mjmorano/Magnetometer-System/3D Models/Magnetometer_Full.stp

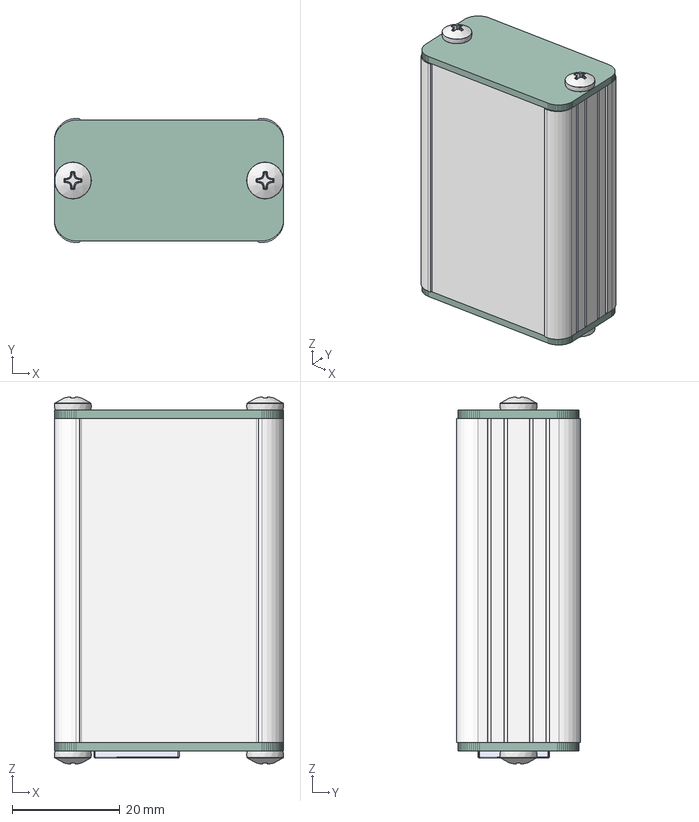
[picture p1: CAD file, 2025-02-03]
3D Models/Magnetometer_Full.stp
42.5 x 23.0 x 68.0 mm
Extrusion Tube w. Inlay 60mm
Rear Panel_1
magnetometer panel PCB
C_1206_3216Metric_1 x 4
R_Array_Convex_4x0603_1 x 2
R_0603_1608Metric_1 x 6
C_0603_1608Metric_1 x 5
SSOP_16_39x49mm_P0635mm
SOIC_8_39x49mm_P127mm x 3
CQ assembly
D_SOD_123F
DIP-8_W7.62mm_1
A-2004-2-4-LPS-N-R
Magnetometer PCB
91735A146_316 Stainless Steel Pan Head Phillips Screw x 4
