mjmorano/Magnetometer-System/KiCad/Controller/3D Models/CUI_DEVICES_PJ-002BH.step

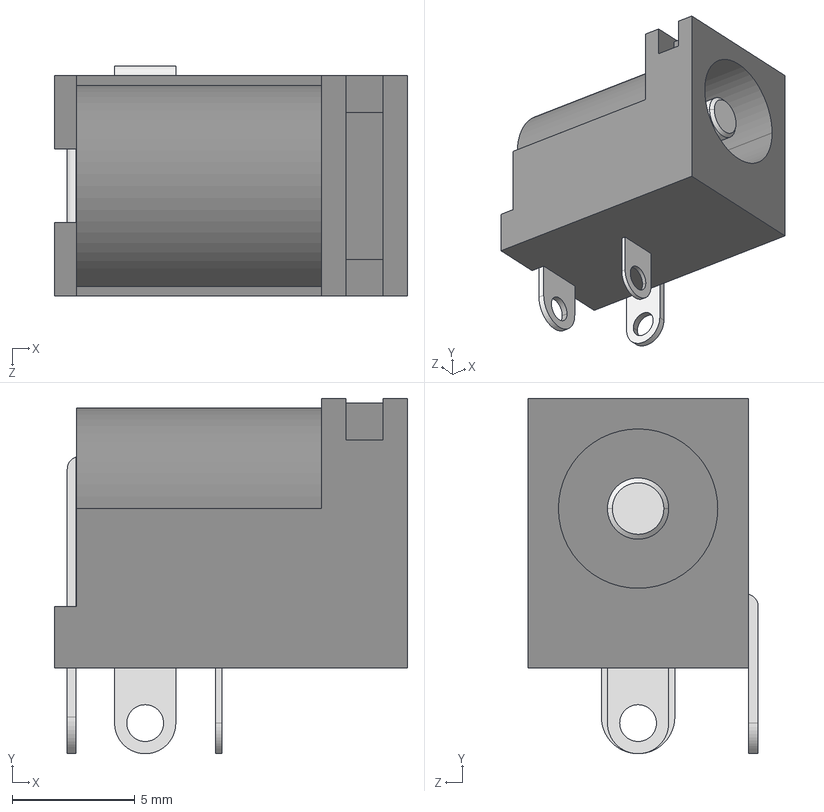
[picture p2: CAD file, 2025-02-03]
KiCad/Controller/3D Models/CUI_DEVICES_PJ-002BH.step
14.4 x 14.5 x 9.40 mm
