mjmorano/Magnetometer-System/KiCad/Magnetometer/3D Models/1049P.step

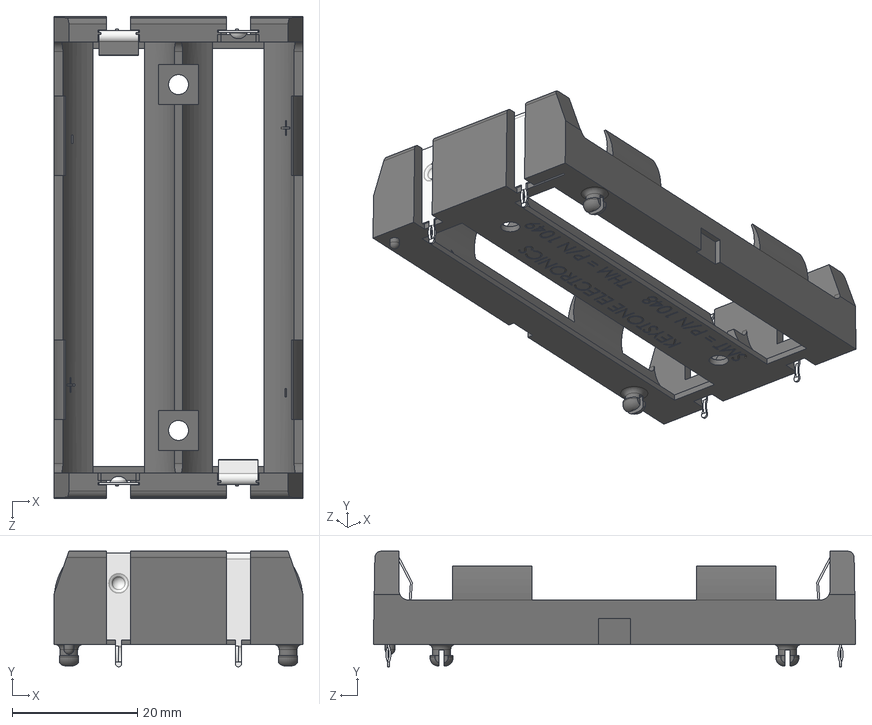
[picture p3: CAD file, 2025-02-03]
KiCad/Magnetometer/3D Models/1049P.step
39.8 x 18.5 x 77.1 mm
