mjmorano/Magnetometer-System/KiCad/Magnetometer/3D Models/CAP_TAJ-W-2312-LP_AVX.step

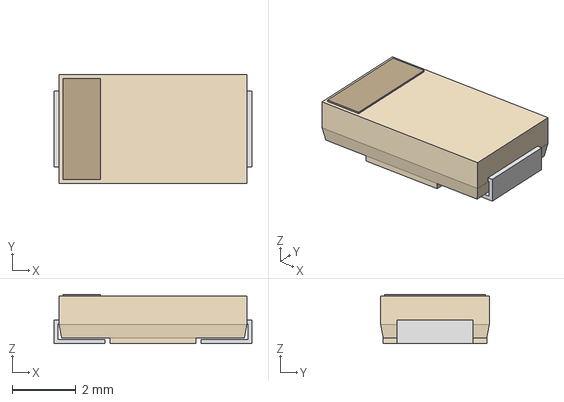
[picture p4: CAD file, 2025-02-03]
KiCad/Magnetometer/3D Models/CAP_TAJ-W-2312-LP_AVX.step
6.20 x 3.40 x 1.55 mm
