mjmorano/Magnetometer-System/KiCad/Magnetometer/3D Models/rj45.step

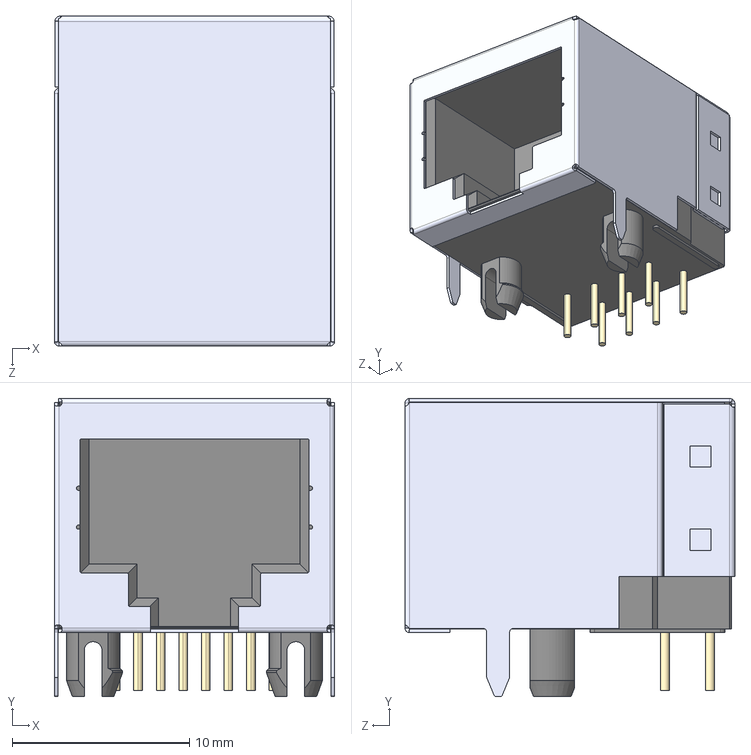
[picture p5: CAD file, 2025-02-03]
KiCad/Magnetometer/3D Models/rj45.step
15.8 x 16.8 x 18.6 mm
