mjmorano/Magnetometer-System/KiCad/Magnetometer/Magnetometer.kicad_pcb

## KiCad design KiCad/Magnetometer/Magnetometer.kicad_pcb (2025-01-29)

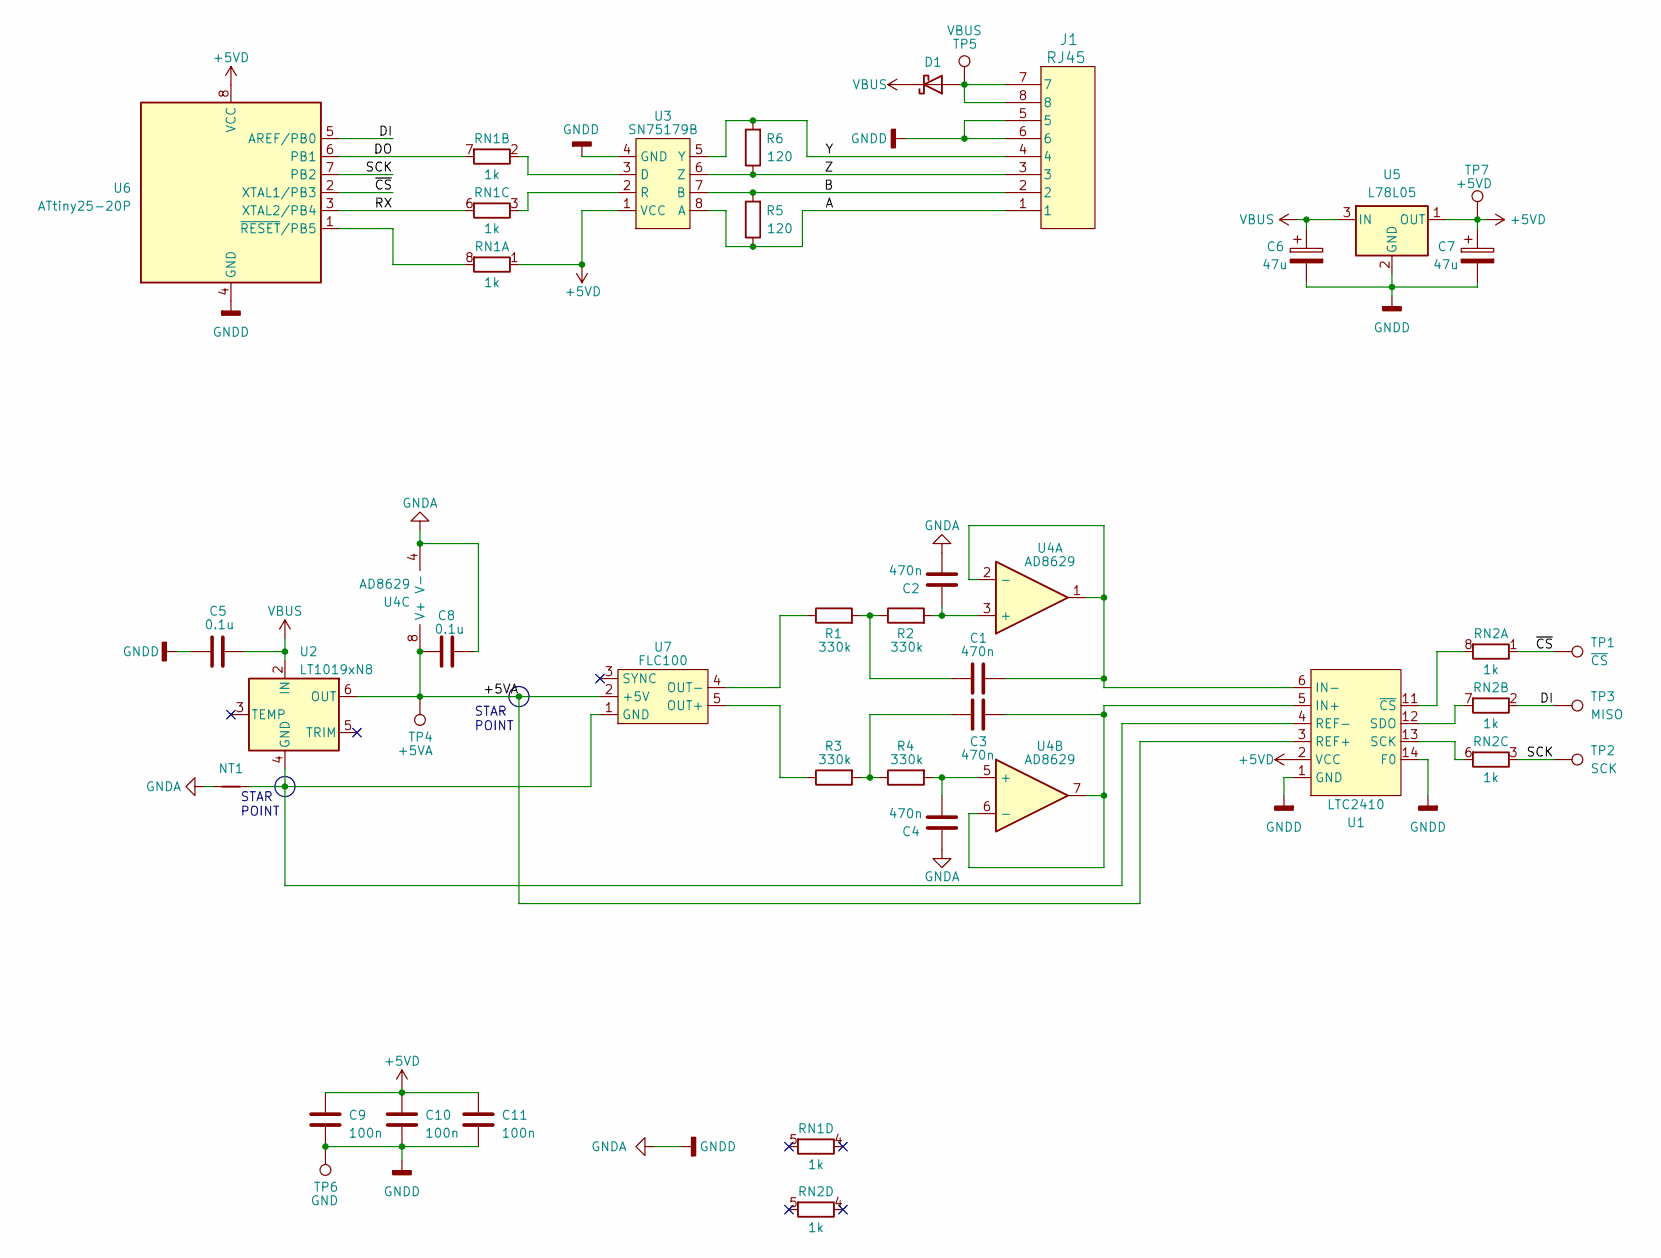
[picture p6: schematic Magnetometer.kicad_sch]

Parts:
C1, C2, C3, C4: 470n; C_1206_3216Metric
C5, C8: 0.1u; C_0603_1608Metric
C6, C7: 47u; CP_EIA-6032-28_Kemet-C
C9, C10, C11: 100n; C_0603_1608Metric
D1: D_Schottky; D_SOD-123F
J1: RJ45; rj45
NT1: NetTie-2_SMD_Pad0.5mm
R1, R2, R3, R4: 330k; R_0603_1608Metric
R5, R6: 120; R_0603_1608Metric
RN1, RN2: 1k; R_Array_Convex_4x0603
TP1: ~{CS}; TestPoint_Pad_D1.0mm
TP2: SCK; TestPoint_Pad_D1.0mm
TP3: MISO; TestPoint_Pad_D1.0mm
TP4: +5VA; TestPoint_Pad_D1.0mm
TP5: VBUS; TestPoint_Pad_D1.0mm
TP6: GND; TestPoint_Pad_D1.0mm
TP7: +5VD; TestPoint_Pad_D1.0mm
U1: LTC2410; SSOP-16_3.9x4.9mm_P0.635mm
U2: LT1019xN8; SOIC-8_3.9x4.9mm_P1.27mm
U3: SN75179B; SOIC-8_3.9x4.9mm_P1.27mm
U4: AD8629; SOIC-8_3.9x4.9mm_P1.27mm
U5: L78L05; SOT-89-3
U6: ATtiny25-20P; DIP-8_W7.62mm
U7: FLC100

Connections:
+5VD: C7.1, C9.1, C10.1, C11.1, RN1.1 (R1.1), TP7.1, U1.2 (VCC), U3.1 (VCC), U5.1 (OUT), U6.8 (VCC)
/+5VA: C8.1, TP4.1, U1.3 (REF+), U2.6 (OUT), U4.8 (V+), U7.2 (+5V)
/A: J1.1, R5.1, U3.8 (A)
/B: J1.2, R5.2, U3.7 (B)
/DI: RN2.2 (R2.1), TP3.1, U6.5 (AREF/PB0)
/DO: RN1.7 (R2.2), U6.6 (PB1)
/RX: RN1.6 (R3.2), U6.3 (XTAL2/PB4)
/SCK: RN2.3 (R3.1), TP2.1, U6.7 (PB2)
/Y: J1.4, R6.2, U3.5 (Y)
/Z: J1.3, R6.1, U3.6 (Z)
/~CS: RN2.1 (R1.1), TP1.1, U6.2 (XTAL1/PB3)
GNDA: C2.2, C4.1, C5.2, C6.2, C7.2, C8.2, C9.2, C10.2, C11.2, J1.5, J1.6, NT1.2, TP6.1, U1.1 (GND), U1.7 (GND), U1.8 (GND), U1.9 (GND), U1.10 (GND), U1.14 (F0), U1.15 (GND), U1.16 (GND), U3.4 (GND), U4.4 (V-), U5.2 (GND), U6.4 (GND)
unnamed: C1.2, R1.2, R2.1
unnamed: C3.2, R3.2, R4.1
unnamed: D1.2 (A), J1.7, J1.8, TP5.1
unnamed: RN1.8 (R1.2), U6.1 (~RESET/PB5)
unnamed: RN1.2 (R2.1), U3.3 (D)
unnamed: RN1.3 (R3.1), U3.2 (R)
unnamed: RN2.8 (R1.2), U1.11 (~CS)
unnamed: RN2.7 (R2.2), U1.12 (SDO)
unnamed: RN2.6 (R3.2), U1.13 (SCK)
unnamed: C3.1, U1.5 (IN+), U4.6 (-), U4.7
unnamed: C1.1, U1.6 (IN-), U4.1, U4.2 (-)
unnamed: NT1.1, U1.4 (REF-), U2.4 (GND), U7.1 (GND)
unnamed: C2.1, R2.2, U4.3 (+)
unnamed: C4.2, R4.2, U4.5 (+)
unnamed: R3.1, U7.5 (OUT+)
unnamed: R1.1, U7.4 (OUT-)
VBUS: C5.1, C6.1, D1.1 (K), U2.2 (IN), U5.3 (IN)

Notes on the sheet:
STAR POINT

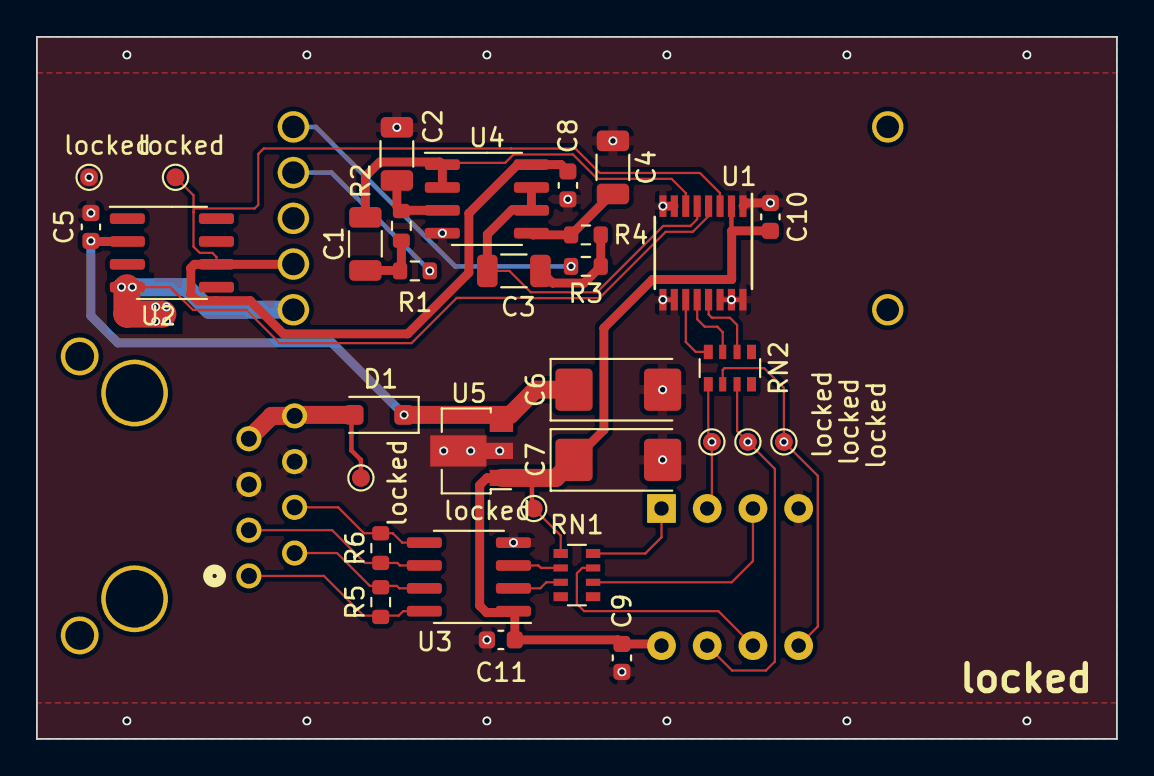
[picture p7: board Magnetometer.kicad_pcb from above]

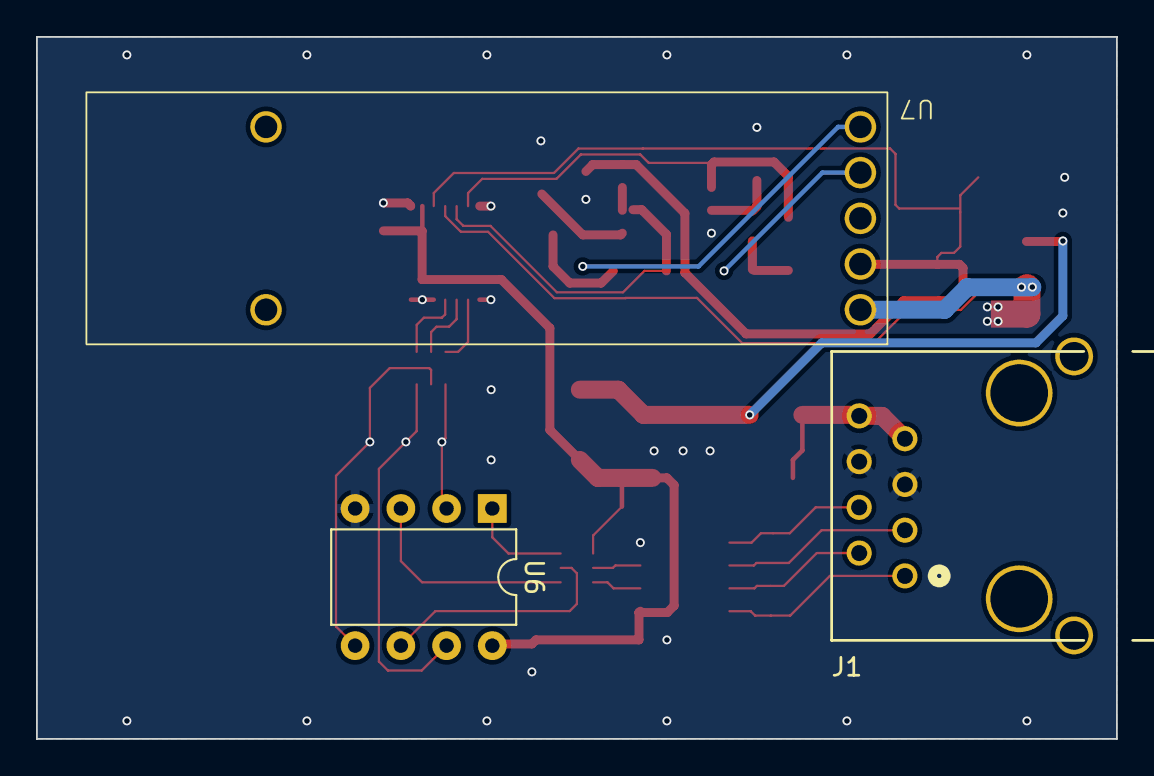
[picture p8: board Magnetometer.kicad_pcb from below]

Board: 2 copper layers, 60.0 x 39.0 mm, 36 parts (3 on the bottom side), 29 nets.
