mjmorano/Magnetometer-System/KiCad/Controller/Magnetometer Controller.kicad_pcb

## KiCad design KiCad/Controller/Magnetometer Controller.kicad_pcb (2025-01-29)

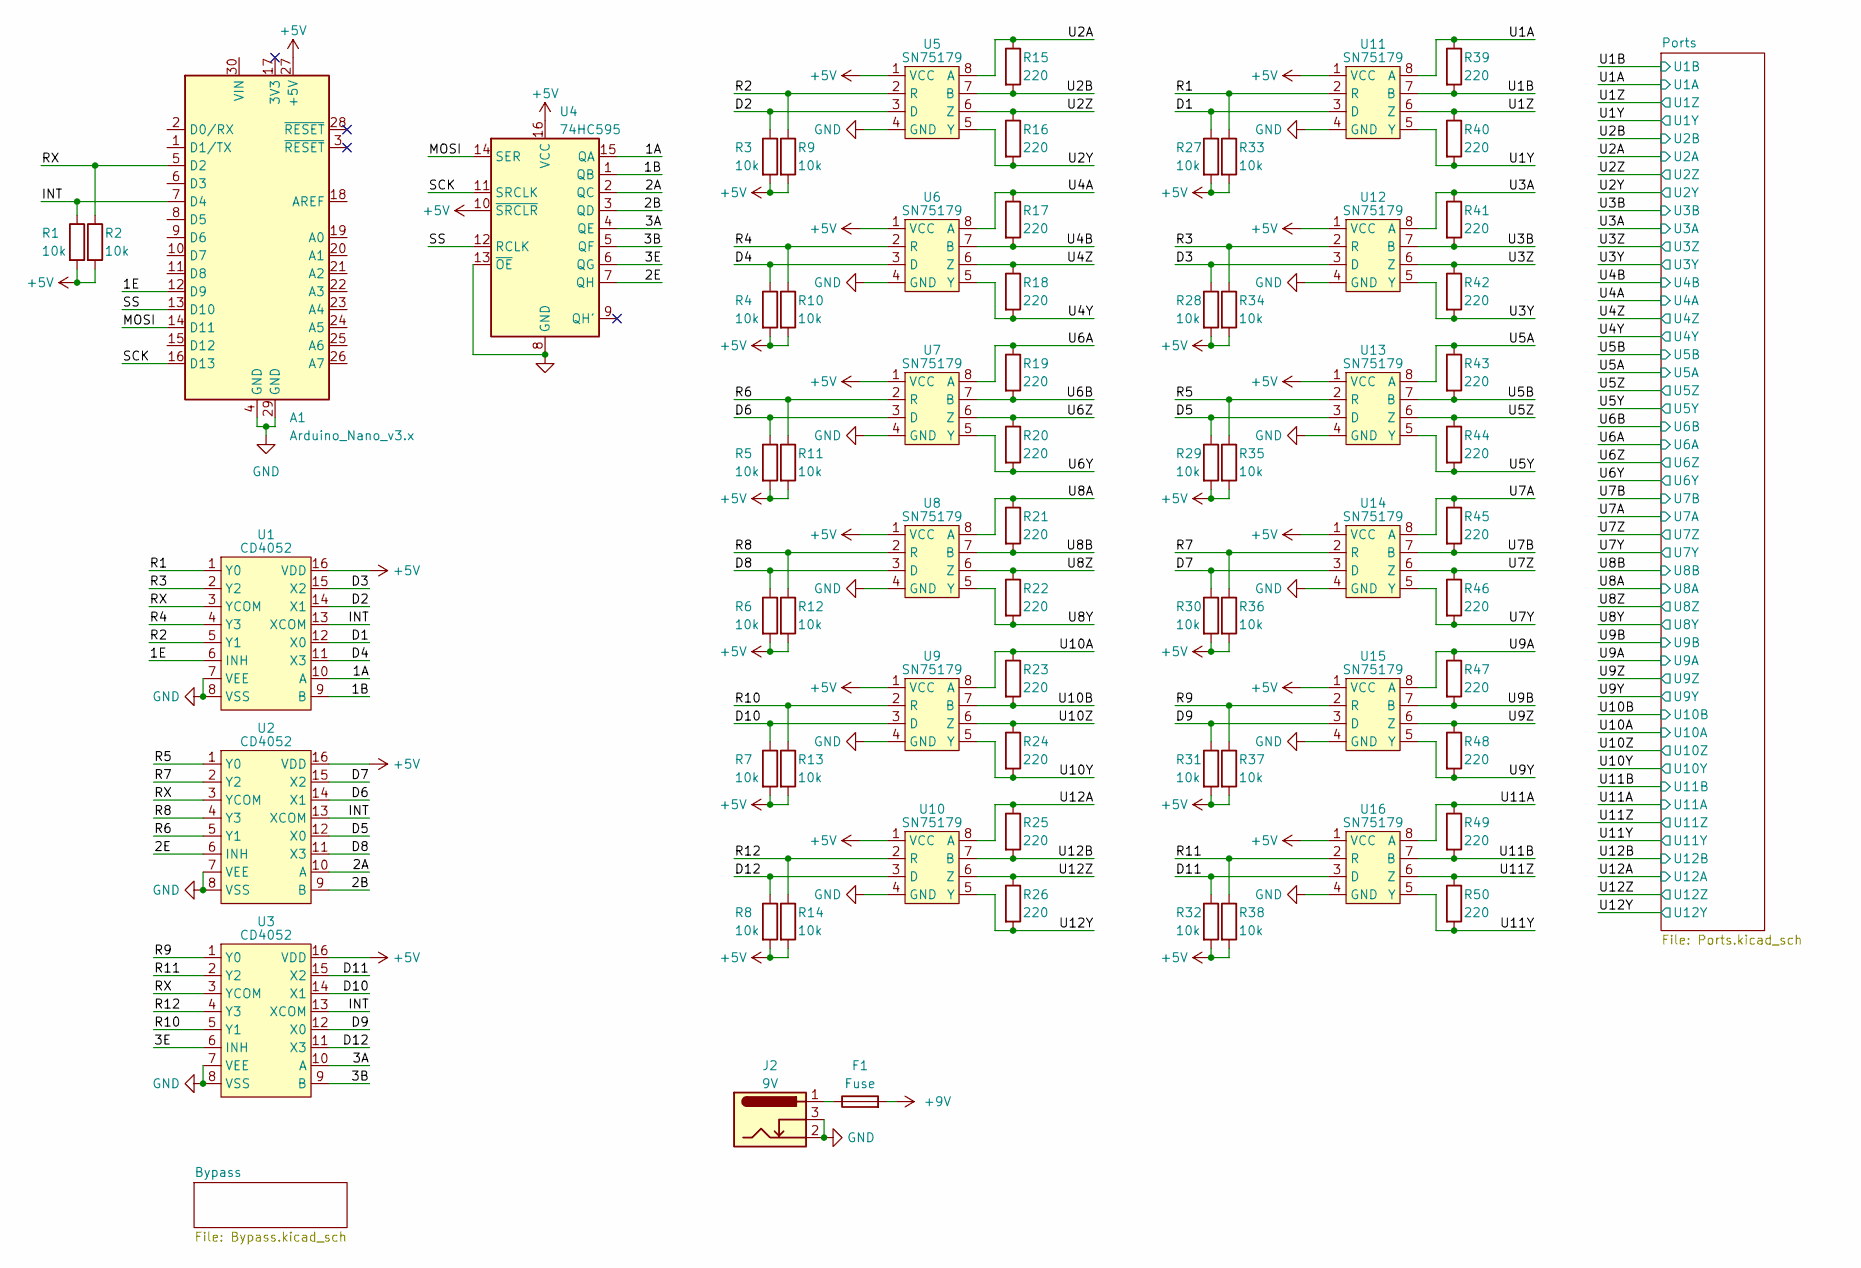
[picture p9: schematic Magnetometer Controller.kicad_sch]

Parts:
A1: Arduino_Nano_v3.x; Arduino_Nano
F1: Fuse; 0031.7701.22
J2: 9V; CUI_PJ-002BH
R1, R2, R3, R4, R5, R6, R7, R8, R9, R10, R11, R12, R13, R14, R27, R28, R29, R30, R31, R32, R33, R34, R35, R36, R37, R38: 10k; R_0603_1608Metric
R15, R16, R17, R18, R19, R20, R21, R22, R23, R24, R25, R26, R39, R40, R41, R42, R43, R44, R45, R46, R47, R48, R49, R50: 220; R_0603_1608Metric
U1, U2, U3: CD4052; SOIC-16_3.9x9.9mm_P1.27mm
U4: 74HC595; SOIC-16_3.9x9.9mm_P1.27mm
U5, U6, U7, U8, U9, U10, U11, U12, U13, U14, U15, U16: SN75179; SOIC-8_3.9x4.9mm_P1.27mm

Connections:
+5V: A1.27 (+5V), R1.2, R2.2, R3.2, R4.2, R5.2, R6.2, R7.2, R8.2, R9.2, R10.2, R11.2, R12.2, R13.2, R14.2, R27.2, R28.2, R29.2, R30.2, R31.2, R32.2, R33.2, R34.2, R35.2, R36.2, R37.2, R38.2, U1.16 (VDD), U2.16 (VDD), U3.16 (VDD), U4.10 (~SRCLR), U4.16 (VCC), U5.1 (VCC), U6.1 (VCC), U7.1 (VCC), U8.1 (VCC), U9.1 (VCC), U10.1 (VCC), U11.1 (VCC), U12.1 (VCC), U13.1 (VCC), U14.1 (VCC), U15.1 (VCC), U16.1 (VCC); also elsewhere on the board
+9V: F1.2; also elsewhere on the board
/1A: U1.10 (A), U4.15 (QA)
/1B: U1.9 (B), U4.1 (QB)
/1E: A1.12 (D9), U1.6 (INH)
/2A: U2.10 (A), U4.2 (QC)
/2B: U2.9 (B), U4.3 (QD)
/2E: U2.6 (INH), U4.7 (QH)
/3A: U3.10 (A), U4.4 (QE)
/3B: U3.9 (B), U4.5 (QF)
/3E: U3.6 (INH), U4.6 (QG)
/D1: R27.1, U1.12 (X0), U11.3 (D)
/D2: R3.1, U1.14 (X1), U5.3 (D)
/D3: R28.1, U1.15 (X2), U12.3 (D)
/D4: R4.1, U1.11 (X3), U6.3 (D)
/D5: R29.1, U2.12 (X0), U13.3 (D)
/D6: R5.1, U2.14 (X1), U7.3 (D)
/D7: R30.1, U2.15 (X2), U14.3 (D)
/D8: R6.1, U2.11 (X3), U8.3 (D)
/D9: R31.1, U3.12 (X0), U15.3 (D)
/D10: R7.1, U3.14 (X1), U9.3 (D)
/D11: R32.1, U3.15 (X2), U16.3 (D)
/D12: R8.1, U3.11 (X3), U10.3 (D)
/INT: A1.7 (D4), R1.1, U1.13 (XCOM), U2.13 (XCOM), U3.13 (XCOM)
/MOSI: A1.14 (D11), U4.14 (SER)
/R1: R33.1, U1.1 (Y0), U11.2 (R)
/R2: R9.1, U1.5 (Y1), U5.2 (R)
/R3: R34.1, U1.2 (Y2), U12.2 (R)
/R4: R10.1, U1.4 (Y3), U6.2 (R)
/R5: R35.1, U2.1 (Y0), U13.2 (R)
/R6: R11.1, U2.5 (Y1), U7.2 (R)
/R7: R36.1, U2.2 (Y2), U14.2 (R)
/R8: R12.1, U2.4 (Y3), U8.2 (R)
/R9: R37.1, U3.1 (Y0), U15.2 (R)
/R10: R13.1, U3.5 (Y1), U9.2 (R)
/R11: R38.1, U3.2 (Y2), U16.2 (R)
/R12: R14.1, U3.4 (Y3), U10.2 (R)
/RX: A1.5 (D2), R2.1, U1.3 (YCOM), U2.3 (YCOM), U3.3 (YCOM)
/SCK: A1.16 (D13), U4.11 (SRCLK)
/SS: A1.13 (D10), U4.12 (RCLK)
/U1A: R39.1, U11.8 (A); also elsewhere on the board
/U1B: R39.2, U11.7 (B); also elsewhere on the board
/U1Y: R40.2, U11.5 (Y); also elsewhere on the board
/U1Z: R40.1, U11.6 (Z); also elsewhere on the board
/U2A: R15.1, U5.8 (A); also elsewhere on the board
/U2B: R15.2, U5.7 (B); also elsewhere on the board
/U2Y: R16.2, U5.5 (Y); also elsewhere on the board
/U2Z: R16.1, U5.6 (Z); also elsewhere on the board
/U3A: R41.1, U12.8 (A); also elsewhere on the board
/U3B: R41.2, U12.7 (B); also elsewhere on the board
/U3Y: R42.2, U12.5 (Y); also elsewhere on the board
/U3Z: R42.1, U12.6 (Z); also elsewhere on the board
/U4A: R17.1, U6.8 (A); also elsewhere on the board
/U4B: R17.2, U6.7 (B); also elsewhere on the board
/U4Y: R18.2, U6.5 (Y); also elsewhere on the board
/U4Z: R18.1, U6.6 (Z); also elsewhere on the board
/U5A: R43.1, U13.8 (A); also elsewhere on the board
/U5B: R43.2, U13.7 (B); also elsewhere on the board
/U5Y: R44.2, U13.5 (Y); also elsewhere on the board
/U5Z: R44.1, U13.6 (Z); also elsewhere on the board
/U6A: R19.1, U7.8 (A); also elsewhere on the board
/U6B: R19.2, U7.7 (B); also elsewhere on the board
/U6Y: R20.2, U7.5 (Y); also elsewhere on the board
/U6Z: R20.1, U7.6 (Z); also elsewhere on the board
/U7A: R45.1, U14.8 (A); also elsewhere on the board
/U7B: R45.2, U14.7 (B); also elsewhere on the board
/U7Y: R46.2, U14.5 (Y); also elsewhere on the board
/U7Z: R46.1, U14.6 (Z); also elsewhere on the board
/U8A: R21.1, U8.8 (A); also elsewhere on the board
/U8B: R21.2, U8.7 (B); also elsewhere on the board
/U8Y: R22.2, U8.5 (Y); also elsewhere on the board
/U8Z: R22.1, U8.6 (Z); also elsewhere on the board
/U9A: R47.1, U15.8 (A); also elsewhere on the board
/U9B: R47.2, U15.7 (B); also elsewhere on the board
/U9Y: R48.2, U15.5 (Y); also elsewhere on the board
/U9Z: R48.1, U15.6 (Z); also elsewhere on the board
/U10A: R23.1, U9.8 (A); also elsewhere on the board
/U10B: R23.2, U9.7 (B); also elsewhere on the board
/U10Y: R24.2, U9.5 (Y); also elsewhere on the board
/U10Z: R24.1, U9.6 (Z); also elsewhere on the board
/U11A: R49.1, U16.8 (A); also elsewhere on the board
/U11B: R49.2, U16.7 (B); also elsewhere on the board
/U11Y: R50.2, U16.5 (Y); also elsewhere on the board
/U11Z: R50.1, U16.6 (Z); also elsewhere on the board
/U12A: R25.1, U10.8 (A); also elsewhere on the board
/U12B: R25.2, U10.7 (B); also elsewhere on the board
/U12Y: R26.2, U10.5 (Y); also elsewhere on the board
/U12Z: R26.1, U10.6 (Z); also elsewhere on the board
GND: A1.4 (GND), A1.29 (GND), J2.2, J2.3, U1.7 (VEE), U1.8 (VSS), U2.7 (VEE), U2.8 (VSS), U3.7 (VEE), U3.8 (VSS), U4.8 (GND), U4.13 (~OE), U5.4 (GND), U6.4 (GND), U7.4 (GND), U8.4 (GND), U9.4 (GND), U10.4 (GND), U11.4 (GND), U12.4 (GND), U13.4 (GND), U14.4 (GND), U15.4 (GND), U16.4 (GND); also elsewhere on the board
unnamed: F1.1, J2.1

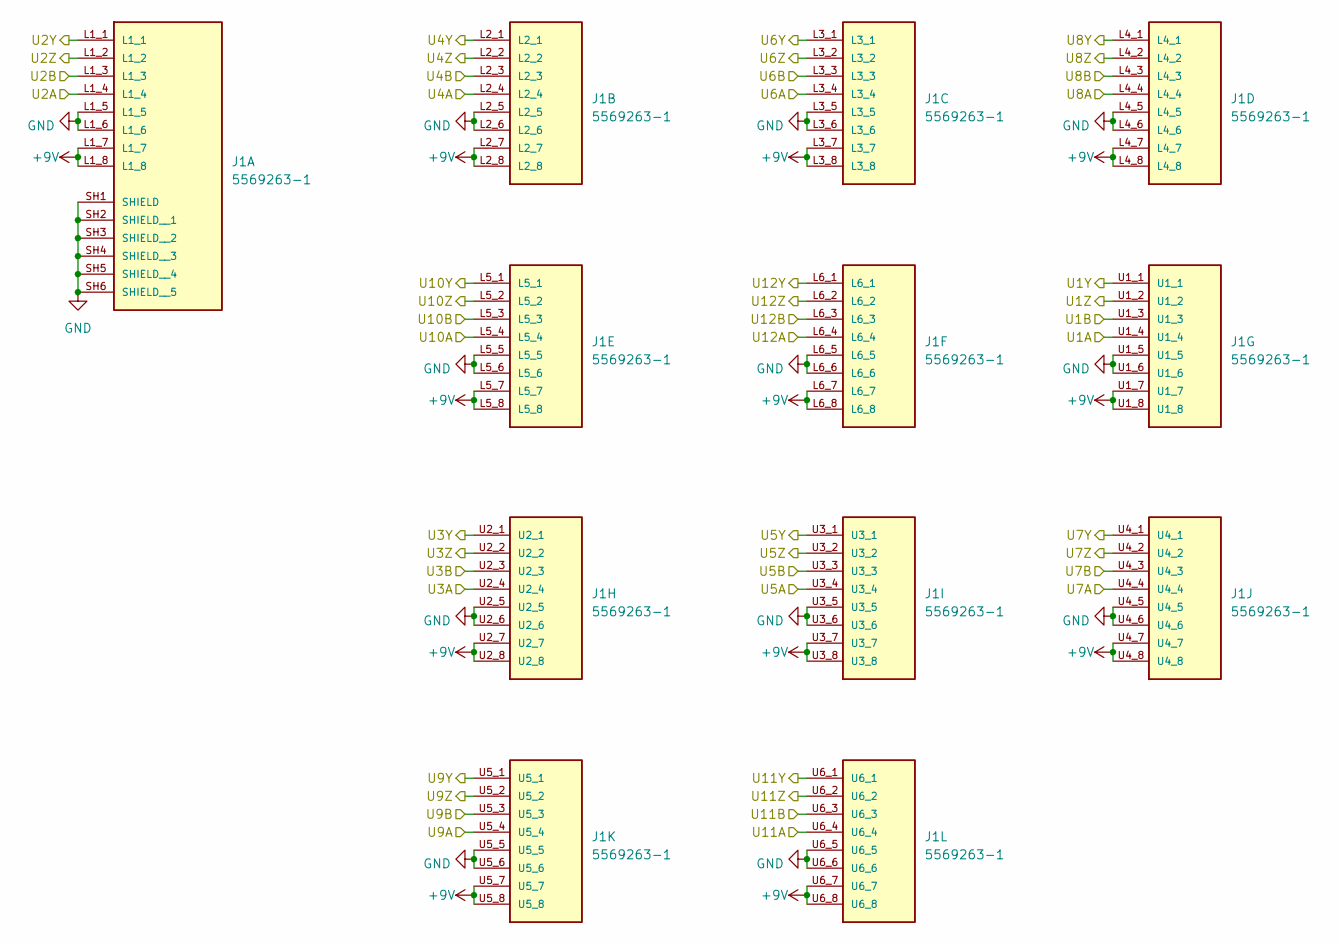
[picture p10: schematic Ports.kicad_sch]

Parts:
J1: 5569263-1; TE_5569263-1; PARTREV B3

Connections:
+9V: J1.L1_7, J1.L1_8, J1.L2_7, J1.L2_8, J1.L3_7, J1.L3_8, J1.L4_7, J1.L4_8, J1.L5_7, J1.L5_8, J1.L6_7, J1.L6_8, J1.U1_7, J1.U1_8, J1.U2_7, J1.U2_8, J1.U3_7, J1.U3_8, J1.U4_7, J1.U4_8, J1.U5_7, J1.U5_8, J1.U6_7, J1.U6_8; also elsewhere on the board
/U1A: J1.U1_4; also elsewhere on the board
/U1B: J1.U1_3; also elsewhere on the board
/U1Y: J1.U1_1; also elsewhere on the board
/U1Z: J1.U1_2; also elsewhere on the board
/U2A: J1.L1_4; also elsewhere on the board
/U2B: J1.L1_3; also elsewhere on the board
/U2Y: J1.L1_1; also elsewhere on the board
/U2Z: J1.L1_2; also elsewhere on the board
/U3A: J1.U2_4; also elsewhere on the board
/U3B: J1.U2_3; also elsewhere on the board
/U3Y: J1.U2_1; also elsewhere on the board
/U3Z: J1.U2_2; also elsewhere on the board
/U4A: J1.L2_4; also elsewhere on the board
/U4B: J1.L2_3; also elsewhere on the board
/U4Y: J1.L2_1; also elsewhere on the board
/U4Z: J1.L2_2; also elsewhere on the board
/U5A: J1.U3_4; also elsewhere on the board
/U5B: J1.U3_3; also elsewhere on the board
/U5Y: J1.U3_1; also elsewhere on the board
/U5Z: J1.U3_2; also elsewhere on the board
/U6A: J1.L3_4; also elsewhere on the board
/U6B: J1.L3_3; also elsewhere on the board
/U6Y: J1.L3_1; also elsewhere on the board
/U6Z: J1.L3_2; also elsewhere on the board
/U7A: J1.U4_4; also elsewhere on the board
/U7B: J1.U4_3; also elsewhere on the board
/U7Y: J1.U4_1; also elsewhere on the board
/U7Z: J1.U4_2; also elsewhere on the board
/U8A: J1.L4_4; also elsewhere on the board
/U8B: J1.L4_3; also elsewhere on the board
/U8Y: J1.L4_1; also elsewhere on the board
/U8Z: J1.L4_2; also elsewhere on the board
/U9A: J1.U5_4; also elsewhere on the board
/U9B: J1.U5_3; also elsewhere on the board
/U9Y: J1.U5_1; also elsewhere on the board
/U9Z: J1.U5_2; also elsewhere on the board
/U10A: J1.L5_4; also elsewhere on the board
/U10B: J1.L5_3; also elsewhere on the board
/U10Y: J1.L5_1; also elsewhere on the board
/U10Z: J1.L5_2; also elsewhere on the board
/U11A: J1.U6_4; also elsewhere on the board
/U11B: J1.U6_3; also elsewhere on the board
/U11Y: J1.U6_1; also elsewhere on the board
/U11Z: J1.U6_2; also elsewhere on the board
/U12A: J1.L6_4; also elsewhere on the board
/U12B: J1.L6_3; also elsewhere on the board
/U12Y: J1.L6_1; also elsewhere on the board
/U12Z: J1.L6_2; also elsewhere on the board
GND: J1.L1_5, J1.L1_6, J1.L2_5, J1.L2_6, J1.L3_5, J1.L3_6, J1.L4_5, J1.L4_6, J1.L5_5, J1.L5_6, J1.L6_5, J1.L6_6, J1.SH1 (SHIELD), J1.SH2 (SHIELD__1), J1.SH3 (SHIELD__2), J1.SH4 (SHIELD__3), J1.SH5 (SHIELD__4), J1.SH6 (SHIELD__5), J1.U1_5, J1.U1_6, J1.U2_5, J1.U2_6, J1.U3_5, J1.U3_6, J1.U4_5, J1.U4_6, J1.U5_5, J1.U5_6, J1.U6_5, J1.U6_6; also elsewhere on the board

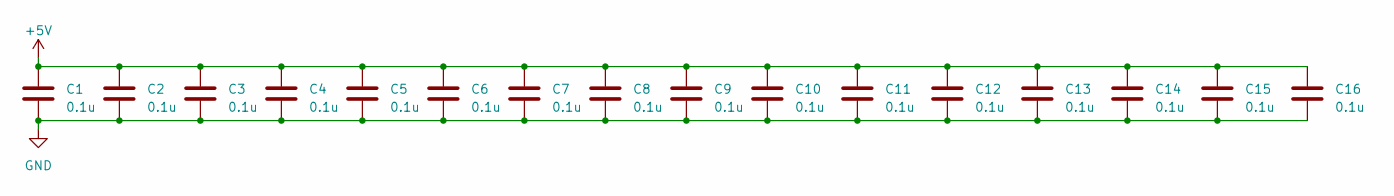
[picture p11: schematic Bypass.kicad_sch]

Parts:
C1, C2, C3, C4, C5, C6, C7, C8, C9, C10, C11, C12, C13, C14, C15, C16: 0.1u; C_0603_1608Metric

Connections:
+5V: C1.1, C2.1, C3.1, C4.1, C5.1, C6.1, C7.1, C8.1, C9.1, C10.1, C11.1, C12.1, C13.1, C14.1, C15.1, C16.1; also elsewhere on the board
GND: C1.2, C2.2, C3.2, C4.2, C5.2, C6.2, C7.2, C8.2, C9.2, C10.2, C11.2, C12.2, C13.2, C14.2, C15.2, C16.2; also elsewhere on the board

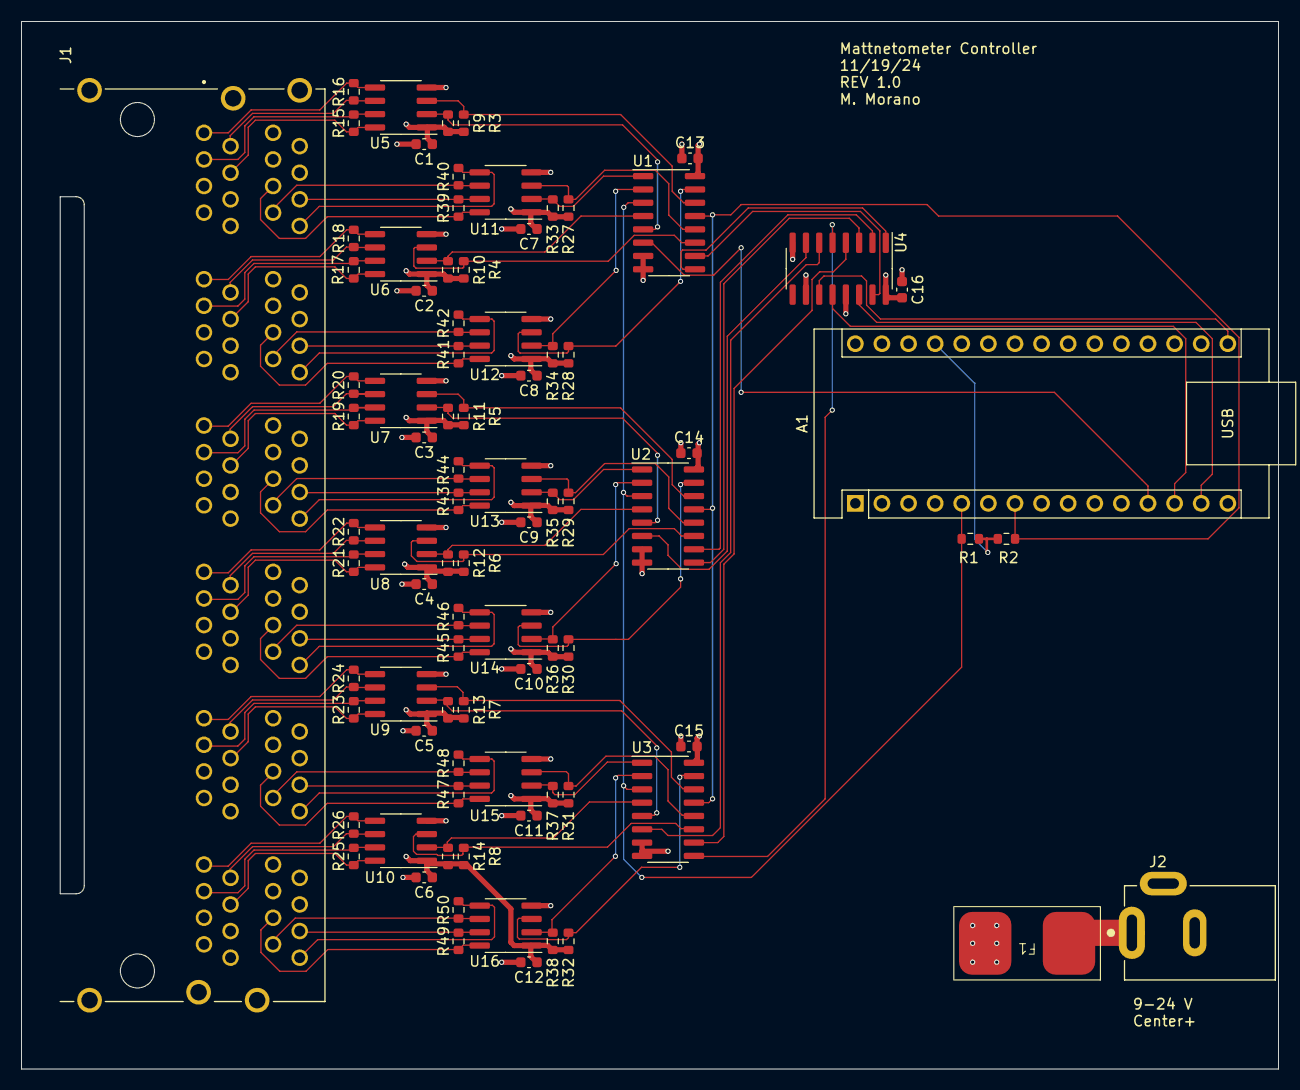
[picture p12: board Magnetometer Controller.kicad_pcb from above]

Board: 4 copper layers, 120.0 x 100.0 mm, 86 parts (0 on the bottom side), 90 nets.
