mjmorano/Magnetometer-System/(commit log)

2025-01-29 Added KiCad backups to gitignore
2025-01-29 Removed KiCad backups
2025-02-03 Added .step models for everything
    [1049P.step, CAP_TAJ-W-2312-LP_AVX.step, CUI_DEVICES_PJ-002BH.step, Magnetometer_Full.stp, rj45.step]
2025-04-28 Added ArduinoISP configuration
2025-04-28 Fixed the upload not setting the fuses correctly
